w32agobot/SKY130_LDO_foldedcascode/(commit log)

2023-04-10 initial OTA
    [_template.sch, ldo_fc.sch, ldo_isource.sch, ldo_isource_eval.sch, ldo_ota.sch, ldo_ota_tb.sch, ldo_pmos_eval.sch]
2023-04-10 gmid dimensioning MP4 MN4
    [gmid.sch, ldo_fc.sch, ldo_ota.sch, ldo_ota_tb.sch]
2023-04-11 add AC sim
    [ldo_fc.sch, ldo_ota.sch, ldo_ota_tb.sch]
2023-04-11 ldo schematic
    [const_curr_source_tb_dimensioning.sch, gmid.sch, isource_res_transistor_tb.sch, ldo.sch, ldo_fc_n.sch, ldo_isource.sch, ldo_ota.sch, ldo_ota_tb.sch]
2023-04-12 optimize OTA tf
    [ldo.sch, ldo_fc_n.sch, ldo_isource.sch, ldo_ota.sch, ldo_ota_tb.sch, ldo_tb.sch]
2023-04-12 optimize ldo tb
    [ldo.sch, ldo_ota_tb.sch, ldo_tb.sch]
2023-04-12 RDME better and added similar load in AC sim
    [ldo_tb.sch]
2023-06-24 updated doc, power transistor
    [ldo.sch, ldo_fc_n.sch, ldo_isource_eval.sch, ldo_ota_tb.sch, ldo_pmos_eval.sch, ldo_tb.sch]
2023-06-25 update to MC simulation, reduce current
    [ldo_fc_n.sch, ldo_ota.sch, ldo_ota_tb.sch, ldo_tb.sch]
2023-06-25 remove compensation R, RHPZ is not critical
    [ldo.sch, ldo_tb.sch]
2023-06-26 decreased current
    [ldo_fc_n.sch, ldo_ota_tb.sch, ldo_tb.sch]
2023-07-19 annotate, optimize
    [ldo.sch, ldo_fc_n.sch, ldo_isource_eval.sch, ldo_ota.sch, ldo_ota_tb.sch, ldo_pmos_eval.sch, ldo_tb.sch]
2023-07-19 optimize gain by Av=.. formula
    [gain.xlsx, ldo_fc_n.sch, ldo_ota.sch, ldo_ota_tb.sch, ldo_tb.sch]
2023-07-20 add noise analysis
    [ldo_ota.sch, ldo_ota_tb.sch, ldo_tb.sch]
2023-07-20 update cmrr sim
    [ldo_ota_tb.sch, ldo_tb.sch]
2023-07-20 add closed loop gain
    [ldo_tb.sch]
